tesliuk/tesliuk/keyboard/build/case/tray_right.stl

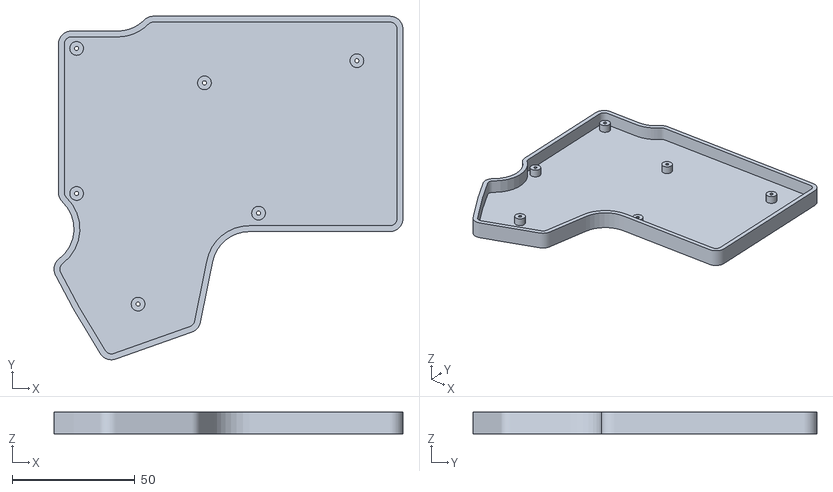
[picture p2: CAD file, 2026-08-15]
keyboard/build/case/tray_right.stl
141.9 x 139.7 x 8.90
