tesliuk/tesliuk/keyboard/build/outlines/plate_left.dxf

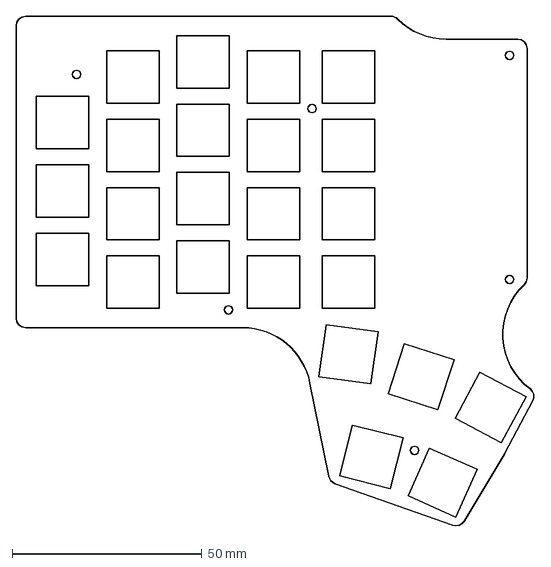
[picture p3: CAD file, 2026-08-15]
keyboard/build/outlines/plate_left.dxf
136.6 x 134.4 mm
