tesliuk/tesliuk/keyboard/build/case/plate_right.stl

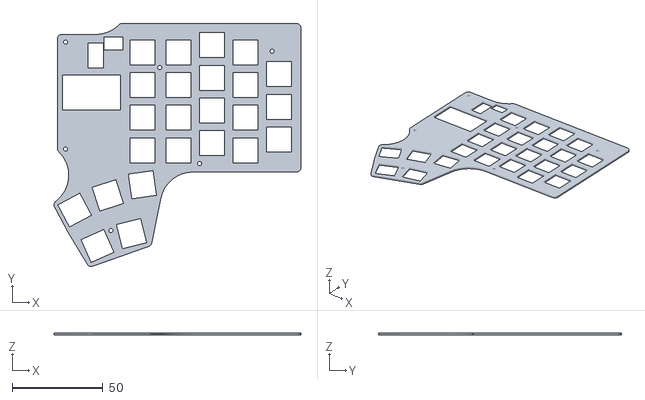
[picture p4: CAD file, 2026-08-15]
keyboard/build/case/plate_right.stl
136.4 x 134.1 x 1.30
