tesliuk/tesliuk/keyboard/build/outlines/preview.dxf

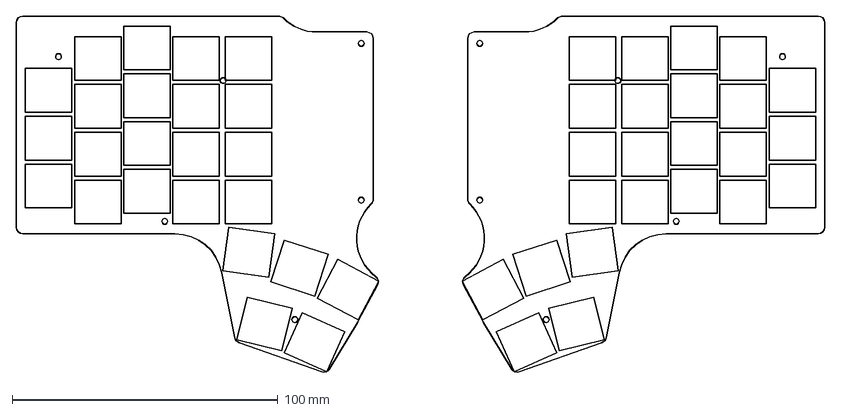
[picture p5: CAD file, 2026-08-15]
keyboard/build/outlines/preview.dxf
304.5 x 134.4 mm
