tesliuk/tesliuk/keyboard/build/outlines/board.dxf

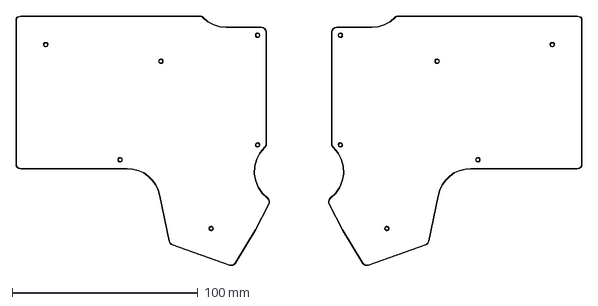
[picture p6: CAD file, 2026-08-15]
keyboard/build/outlines/board.dxf
304.5 x 134.4 mm
