tesliuk/tesliuk/keyboard/build/outlines/board_right.dxf

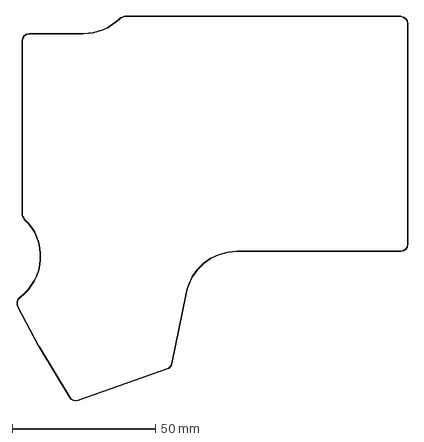
[picture p7: CAD file, 2026-08-15]
keyboard/build/outlines/board_right.dxf
136.6 x 134.4 mm
