tesliuk/tesliuk/keyboard/build/outlines/board_left.dxf

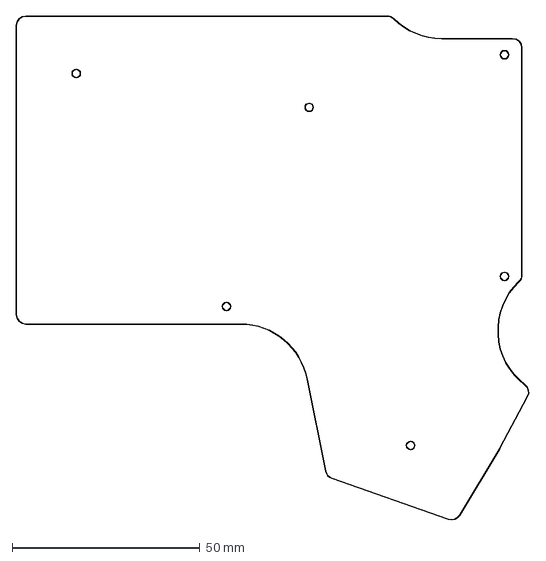
[picture p8: CAD file, 2026-08-15]
keyboard/build/outlines/board_left.dxf
136.6 x 134.4 mm
