tesliuk/tesliuk/(list of files, cad)

Other CAD files:
keyboard/build/case/plate_left.stl
keyboard/build/case/tray_left.stl
