tesliuk/tesliuk/keyboard/build/preview.png

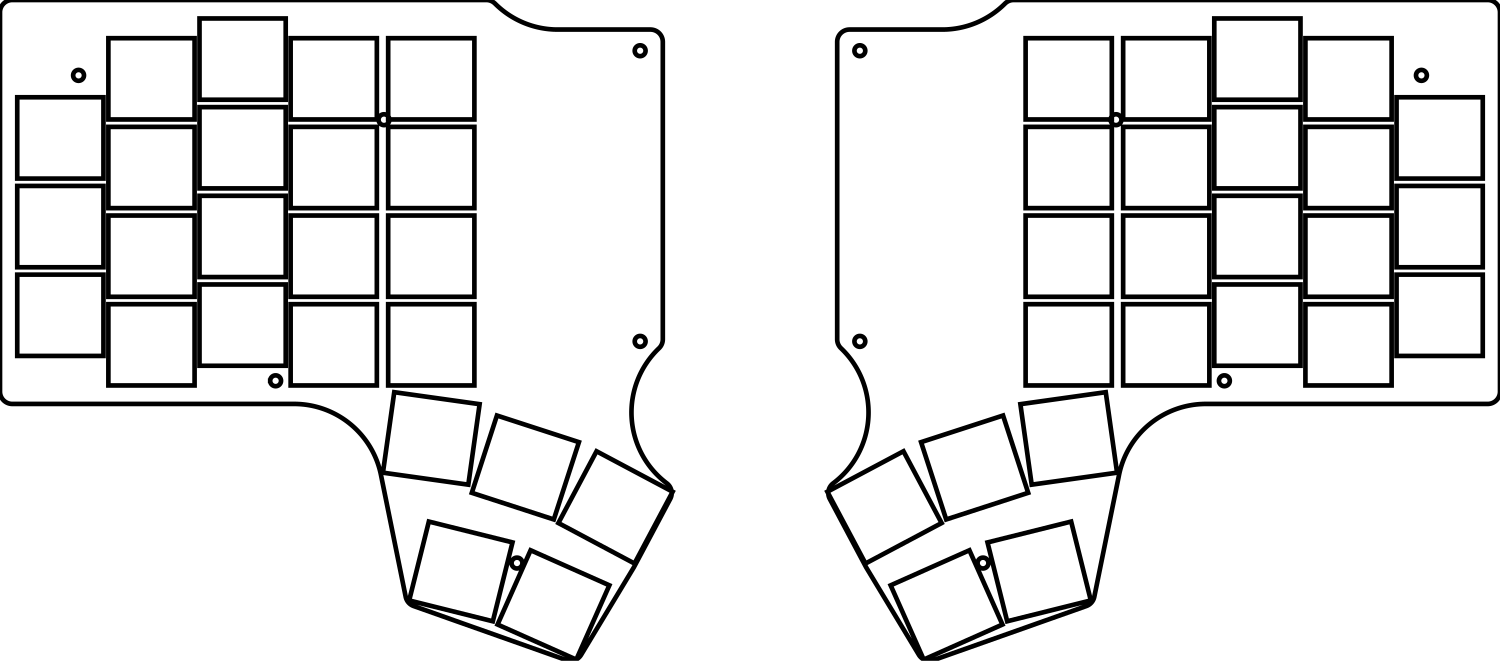
keyboard/build/preview.png
