tesliuk/tesliuk/keyboard/build/pcbs/pinkyless48.kicad_pcb

## KiCad design keyboard/build/pcbs/pinkyless48.kicad_pcb (2026-08-15)

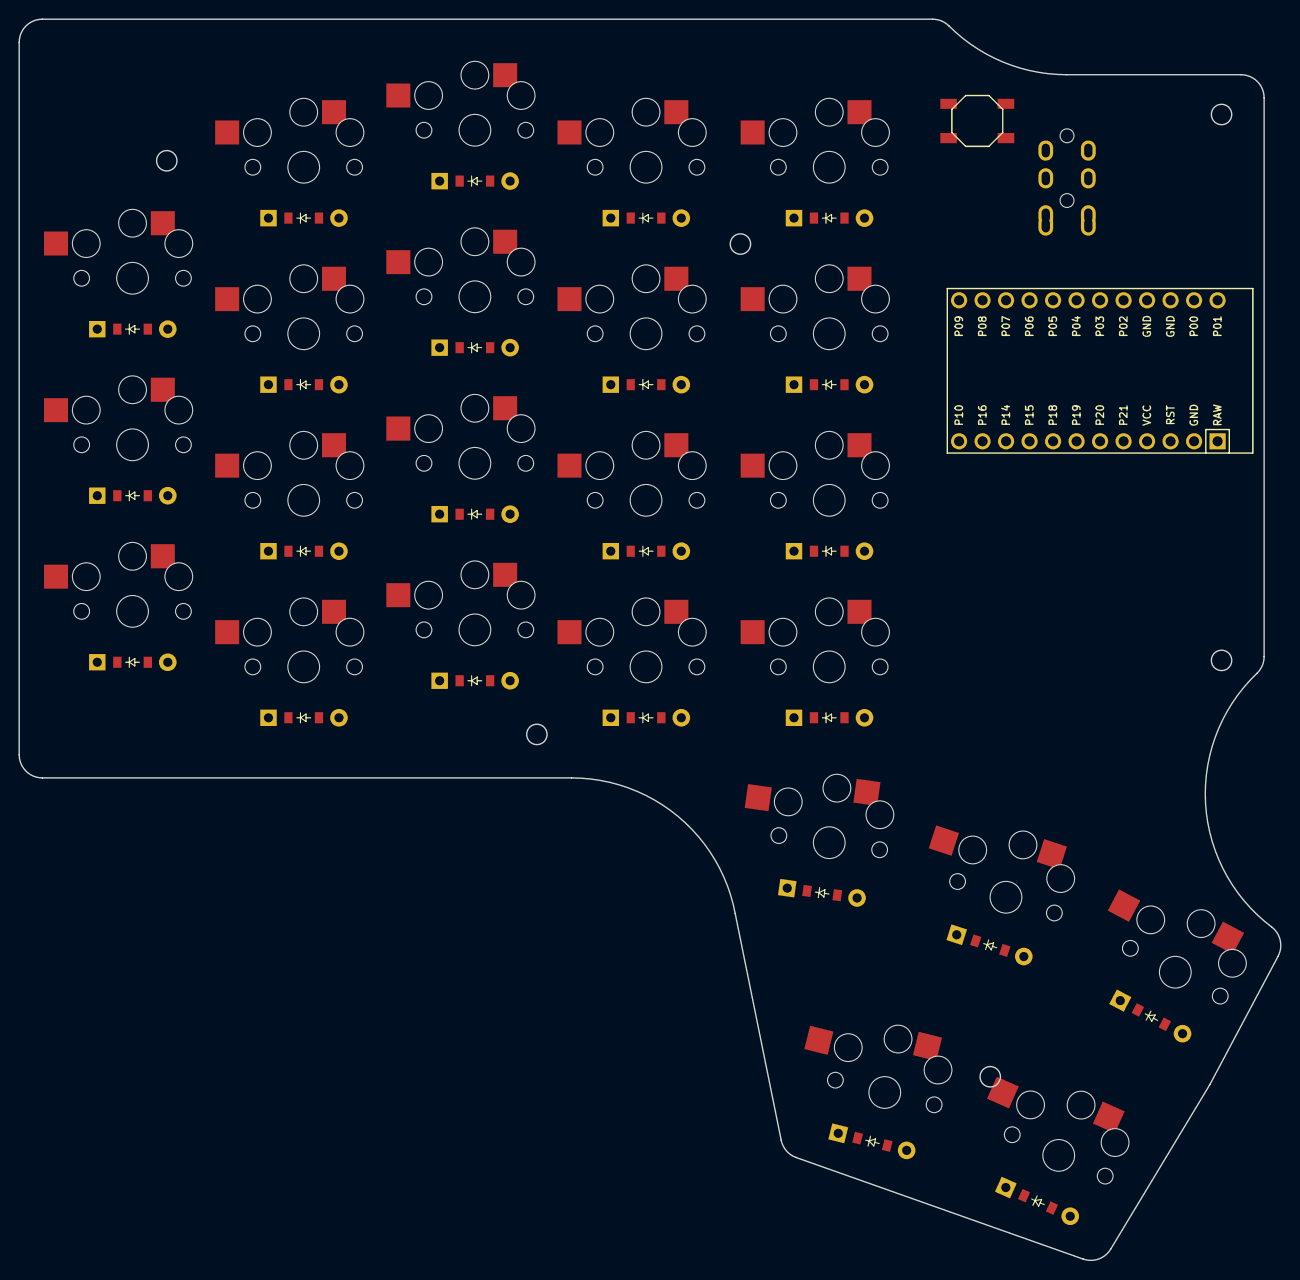
[picture p10: board pinkyless48.kicad_pcb from above]

Board: 2 copper layers, 136.4 x 134.1 mm, 51 parts (0 on the bottom side), 38 nets, no tracks yet.

Parts:
B1: SW_TACT_ALPS_SKQGABE010
D1, D2, D3, D4, D5, D6, D7, D8, D9, D10, D11, D12, D13, D14, D15, D16, D17, D18, D19, D20, D21, D22, D23, D24: ComboDiode
MCU1: ProMicro
S1, S2, S3, S4, S5, S6, S7, S8, S9, S10, S11, S12, S13, S14, S15, S16, S17, S18, S19, S20, S21, S22, S23, S24: PG1350
TRRS1: TRRS-PJ-320A-dual

Connections:
C1: MCU1.22, S1.2, S2.2, S3.2, S20.2
C2: MCU1.23, S4.2, S5.2, S6.2, S7.2, S21.2
C3: MCU1.24, S8.2, S9.2, S10.2, S11.2, S22.2
C4: MCU1.8, S12.2, S13.2, S14.2, S15.2, S23.2
C5: MCU1.7, S16.2, S17.2, S18.2, S19.2, S24.2
DATA: MCU1.13, TRRS1.4
GND: B1.2, MCU1.2, MCU1.15, MCU1.16, TRRS1.1, TRRS1.2
R1: D4.1, D8.1, D12.1, D16.1, MCU1.17
R2: D1.1, D5.1, D9.1, D13.1, D17.1, MCU1.18
R3: D2.1, D6.1, D10.1, D14.1, D18.1, MCU1.19
R4: D3.1, D7.1, D11.1, D15.1, D19.1, MCU1.20
R5: D20.1, D21.1, D22.1, D23.1, D24.1, MCU1.21
RST: B1.1, MCU1.3
VCC: MCU1.1, MCU1.4, TRRS1.3
index_bottom: D12.2, S12.1
index_home: D13.2, S13.1
index_num: D15.2, S15.1
index_top: D14.2, S14.1
inner_bottom: D16.2, S16.1
inner_home: D17.2, S17.1
inner_num: D19.2, S19.1
inner_top: D18.2, S18.1
middle_bottom: D8.2, S8.1
middle_home: D9.2, S9.1
middle_num: D11.2, S11.1
middle_top: D10.2, S10.1
pinky_home: D1.2, S1.1
pinky_num: D3.2, S3.1
pinky_top: D2.2, S2.1
ring_bottom: D4.2, S4.1
ring_home: D5.2, S5.1
ring_num: D7.2, S7.1
ring_top: D6.2, S6.1
t1_thumb: D20.2, S20.1
t2_thumb: D21.2, S21.1
t3_thumb: D22.2, S22.1
t4_thumb: D23.2, S23.1
t5_thumb: D24.2, S24.1
