tesliuk/tesliuk/(commit log)

2026-08-15 Add pinkyless46: 46-key split keyboard PCB, case and firmware
    A complete, parametric design for a 46-key column-staggered split
    keyboard: Kailh Choc v1 low-profile, hotswap, wired, RP2040 + QMK.
    23 keys per half - the pinky column is cut to two keys, and five thumb
    keys per half are arranged as a 3-key arc plus a 2-key island.
    Everything derives from a single source of truth (src/config.yaml):
    the PCB, the case STLs and the QMK keyboard.json are all generated
    from the same key positions, so they cannot drift apart.
    Verification is the substance here. Five checks run under `make check`
    and gate the build:
    layout keycap and switch-body collisions, thumb reachability
    outline board con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
    [board.dxf, board_left.dxf, pinkyless46.kicad_pcb, plate_left.dxf, plate_left.stl, plate_right.stl, preview.dxf, tray_left.stl]
2026-08-15 Move thumb cluster outward to align with the middle column
    The cluster sat too far inboard: the innermost thumb key was at x=104,
    between the index and inner columns, so the thumb had to reach across
    the board rather than drop straight down.
    Re-anchor the thumb zone from matrix_index_bottom to matrix_middle_bottom
    and give t1 an x-shift of exactly 0. That puts t1 directly below the
    middle column - the column with the largest stagger, i.e. the one sitting
    furthest forward - and makes the alignment a structural property of the
    config rather than a constant to maintain by hand. Re-stagger the matrix
    later and the cluster tracks it automatically.
    The cluster translates rigidly 8 mm outward, so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
    [board.dxf, board_left.dxf, pinkyless46.kicad_pcb, plate_left.dxf, plate_left.stl, plate_right.stl, preview.dxf, tray_left.stl]
2026-08-15 Move thumb cluster inboard to start where the finger matrix ends
    Previous attempt moved the cluster the wrong way. The requirement is that
    the NEAREST thumb key line up with the LAST (most inboard) finger column,
    with the cluster extending inboard from there - not tucked back underneath
    the finger columns. Before this, the cluster spanned x=96..133, so its far
    end coincided with the inner column and its near end sat under the middle
    column.
    Re-anchor the thumb zone to matrix_inner_bottom with t1 at an x-shift of
    exactly 0. t1 now sits at x=132, the same x as the inner column, and the
    cluster runs inboard to x=169. As with the previous anchoring, this is
    structural: add or remove a finger co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
    [board.dxf, board_left.dxf, pinkyless46.kicad_pcb, plate_left.dxf, plate_left.stl, plate_right.stl, preview.dxf, tray_left.stl]
2026-08-15 Add pinky number key, flatten stagger, tighten board outline
    Three changes, renaming the board to pinkyless48.
    Pinky gains a third key. It now drops only the bottom row, keeping number,
    top and home. With all five columns present the number row carries a full
    1234567890 across the two halves, so digits no longer need a layer. 24 keys
    per half, 24 of 25 matrix cells used.
    Column stagger reworked to a flat profile: inner, index and ring level with
    each other, middle 4 mm forward, pinky 6 mm back. This is not the usual
    finger-length stagger.
    That change exposed a real constraint. The reversible Choc hotswap footprint
    carries socket pads for BOTH faces and is +/-9.58 mm wide, so two columns a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
    [board.dxf, board_left.dxf, pinkyless48.kicad_pcb, plate_left.dxf, plate_left.stl, plate_right.stl, preview.dxf, tray_left.stl]
2026-08-15 Move controller into the notch beside the thumb cluster
    The strip of board above the matrix was 29.5 mm tall and 41% empty. It
    existed only because the controller was mounted standing on end: a Pro Micro
    is 33 x 18 mm, so vertically it forced the board ~30 mm taller than the
    tallest key just to clear it.
    Because the thumb cluster runs inboard and down, the area outboard of it and
    below the number row is dead space that already sits inside the board's
    bounding box. The controller, TRRS jack and reset button now live there, laid
    flat with the USB port facing inboard so the cable exits between the halves.
    Filling that notch costs nothing in overall size, and the strip above the
    matrix disappea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
    [board.dxf, board_left.dxf, pinkyless48.kicad_pcb, plate_left.dxf, plate_left.stl, plate_right.stl, preview.dxf, tray_left.stl]
2026-08-15 Fill concave notches in the board outline
    The outline had ten concave pockets where the thumb cluster, the controller
    area and the grown key pads met. They are dead space, and their sharp inside
    corners are crack initiation points in both 1.6 mm FR4 and the 1.3 mm printed
    plate.
    The outline is now morphologically closed - grown by 6 mm, then shrunk by the
    same 6 mm - before filleting. That fills any pocket narrower than roughly
    12 mm while leaving the board's overall L-shape alone. A convex hull was the
    obvious alternative and is wrong here: it would swallow the entire empty
    region outboard of the thumb cluster and add roughly 40 cm^2 of pointless
    board.
    Measured effect: pockets 10 -> 1 (t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
    [board.dxf, board_left.dxf, pinkyless48.kicad_pcb, plate_left.dxf, plate_left.stl, plate_right.stl, preview.dxf, tray_left.stl]
2026-08-15 Open up key spacing, fill the inboard bay, enforce clearances
    Three related changes, all driven by measurement rather than eyeballing.
    Key pitch 18 x 17 -> 18.5 x 18. The Choc standard leaves 0.5 mm between MBK
    keycaps in both directions and 2.0 mm between switch base flanges down a
    column. That is what stock Choc boards use and it does work, but it is tight
    for getting a puller under a cap and leaves nothing for caps larger than MBK.
    Now 1.0 mm between caps across columns, 1.5 mm down rows, 3.0 mm between
    flanges - for about 2 mm of width and 3 mm of height.
    Fixed a real defect this exposed: thumb t1 sat 0.36 mm from the inner
    column's bottom keycap and touched outright with 18 x 17 caps,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
    [board.dxf, board_left.dxf, board_right.dxf, pinkyless48.kicad_pcb, plate_left.dxf, plate_left.stl, plate_right.stl, preview.dxf]
2026-08-15 Drop the pinky column further, to 12 mm below the baseline
    The stagger was being applied correctly - every pinky key sat 6 mm lower than
    its neighbours - but the column still read as sitting HIGHER than the rest.
    The cause is not the stagger: the pinky carries three keys and skips the
    BOTTOM row, so its block occupies the upper three row positions and its
    lowest key ended 12 mm above every other column's lowest key.
    Doubling the stagger to 12 mm below the baseline (16 mm below middle) brings
    the whole block down: the pinky's lowest key is now 6 mm above the others
    rather than 12, and its top key sits 12 mm below theirs. The column now reads
    as the lowest one, which is what a short finger wa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
    [board.dxf, board_left.dxf, board_right.dxf, pinkyless48.kicad_pcb, plate_left.dxf, plate_left.stl, plate_right.stl, preview.dxf]
2026-08-15 Rebuild the board silhouette from three simple shapes
    The outline was the union of one grown rectangle per key, so every column
    step and every rotated thumb key left its own scallop and fillet. Straight
    runs were constantly interrupted by small arcs, which is exactly what makes a
    case hard to build against.
    It is now three primitives:
    1. the finger matrix as ONE rectangle spanning every column and row,
    sized parametrically from kx/ky/kx_inner and the staggers
    2. the thumb cluster as a hull over its five keys, with `extend` so the
    hull wraps the key pads rather than the key centres
    3. the controller area as a rectangle
    Measured: the fabricated outline goes from a scalloped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
    [board.dxf, board_left.dxf, board_right.dxf, pinkyless48.kicad_pcb, plate_left.dxf, plate_left.stl, plate_right.stl, preview.dxf]
